DAHEE52/VITA-SmartHome/브레드보드_최종배치_v4.md

# 브레드보드 최종 배치도 (서보모터·INA219 제외)

## 보드 1 — ESP32-S3 (환경 센서 허브)

| 부품 | 위치 | 비고 |
|---|---|---|
| ESP32-S3 | 4~10행, e열(왼쪽 헤더) / i열(오른쪽 헤더) | f·g·h열은 비어있어 점퍼 공간으로 활용 가능 |

### I2C 센서 (BME280 · OLED · BH1750) — 21~25행, a·b·c열
| 행 | 신호 | a열 (BME280) | b열 (OLED) | c열 (BH1750) |
|---|---|---|---|---|
| 21 | 전원 (VIN/VCC) | BME280 VIN | OLED VCC | BH1750 VCC |
| 22 | GND | BME280 GND | OLED GND | BH1750 GND |
| 23 | SCL | BME280 SCL | OLED SCL | BH1750 SCL |
| 24 | SDA | BME280 SDA | OLED SDA | BH1750 SDA |
| 25 | ADDR | — | — | BH1750 ADDR → 22행(GND)에 점퍼로 연결 |

- 21행 → + 레일 (수수케이블)
- 22행 → - 레일 (수수케이블)
- 23행 → ESP32의 SCL용 핀이 꽂힌 행 (수수케이블)
- 24행 → ESP32의 SDA용 핀이 꽂힌 행 (수수케이블)

### PZEM-004T (UART) — 27~30행, a열 — ⚠️ AC 고전압 주의
| 행 | 신호 | 연결 |
|---|---|---|
| 27 | 5V | + 레일 |
| 28 | RX (PZEM) | ESP32 **D3**행 (= 4행) |
| 29 | TX (PZEM) | ESP32 **D2**행 (= 3행) |
| 30 | GND | - 레일 |

> D2(3행)와 D3(4행)이 e열/i열 중 어느 쪽에 있는지에 맞춰, 28·29행에서 반대쪽 열(비어있는 열)로 점퍼를 빼서 연결하세요.
>
> PZEM 본체(AC 입력, CT 클램프)는 브레드보드에 올리지 말고 케이블로 위 4개 행에만 연결하세요.

---

## 보드 2 — XIAO ESP32-S3 (액추에이터 허브)

| 부품 | 위치 | 비고 |
|---|---|---|
| XIAO ESP32-S3 | 1~7행, d열 / h열 | USB-C에 가까운 핀이 1행 (확정) |

### 사용 중인 D번호
| D번호 | 용도 |
|---|---|
| D0 | 사용 자제 (부팅/리셋 관련) |
| D1 | PIR OUT |
| D2 | 채널1 — 조명 LED 직결 (저항 220Ω, 릴레이 모듈 아님) |
| D3 | 릴레이 IN2 |
| D4 | (INA219 SDA — 이번 문서 제외 대상) |
| D5 | (INA219 SCL — 이번 문서 제외 대상) |
| D6 | 릴레이 IN3 |
| D7 | 릴레이 IN4 |

### PIR (HC-SR501) — 17~19행, b열
| 행 | 신호 | 연결 |
|---|---|---|
| 17 | VCC | + 레일 |
| 18 | GND | - 레일 |
| 19 | OUT | XIAO **D1**행 |

> PIR 본체는 브레드보드에 꽂지 않고, 감지 방향으로 따로 배치 후 케이블로 위 3개 행에 연결

### 조명 LED (채널1, 릴레이 모듈 대신 직결) — 23행, a열
| 행 | 신호 | 연결 |
|---|---|---|
| 23 | LED 애노드(+, 긴 다리) | 220Ω 저항 → XIAO **D2**행 |
| 23 | LED 캐소드(-, 짧은 다리) | - 레일 (GND) |

> 릴레이 모듈이 없는 채널 - GPIO(D2)가 HIGH일 때 저항→LED→GND로 전류가 흘러 켜진다
> (active-HIGH). 상세 배선/저항값 근거는 `firmware/DEVICE_CONTROL_GUIDE.md` §1 참고.

### 릴레이 (3채널, 채널2~4) — 24~26행, a열
| 행 | 신호 | 연결 |
|---|---|---|
| 21 | VCC | + 레일 (5V 필요시 별도 5V 레일) |
| 22 | GND | - 레일 |
| 24 | IN2 | XIAO **D3**행 |
| 25 | IN3 | XIAO **D6**행 |
| 26 | IN4 | XIAO **D7**행 |

> 대부분 Active-LOW (GPIO를 LOW로 만들어야 릴레이 ON). 모듈 실제 라벨 확인 필요.

---

## 다음에 채워야 할 것
- [ ] (제외됨) INA219, 서보모터 — 필요할 때 다시 요청
