DAHEE52/VITA-SmartHome/docs/presentation-demo/screenshots/02-main.jpg

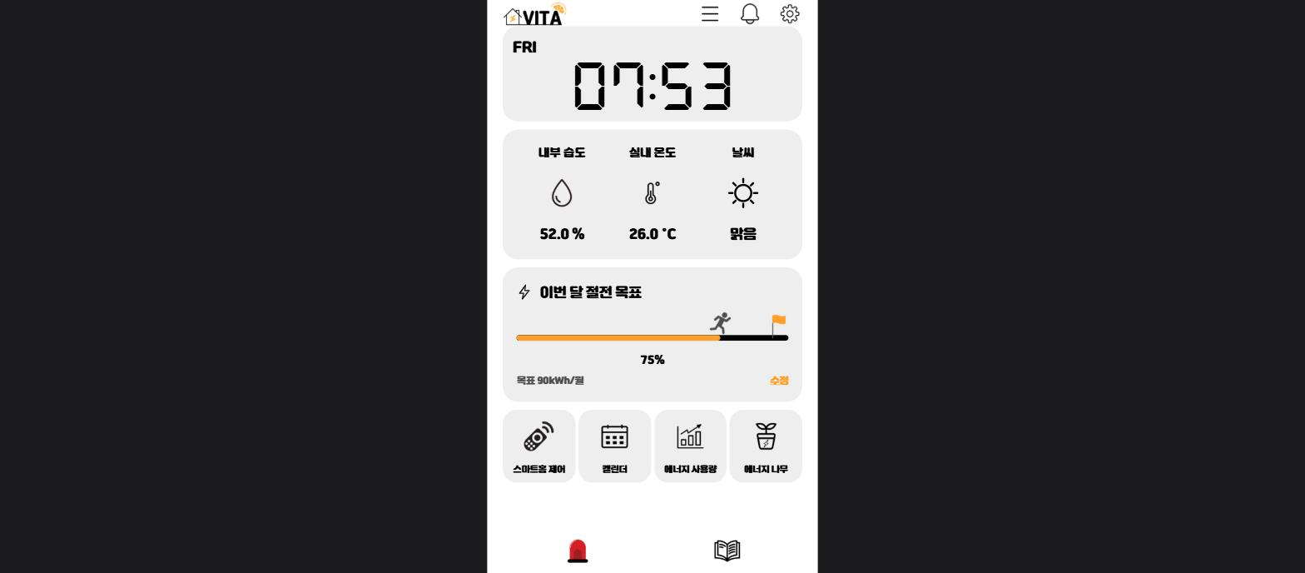
docs/presentation-demo/screenshots/02-main.jpg
