DAHEE52/VITA-SmartHome/guidebook.txt

1. 화재 예방 생활수칙

🔥 화재가 자주 발생하는 원인

- 멀티탭 과부하 및 문어발식 사용
- 사용하지 않는 전기제품 플러그 방치
- 음식 조리 중 자리 비우기
- 휴대폰·보조배터리 과충전
- 담배꽁초 및 라이터 부주의
- 가스레인지 사용 후 밸브 미확인

✔ 생활 속 예방법

- 멀티탭은 정격용량을 확인하고 사용하기
- 전기장판은 접어서 사용하지 않기
- 외출 전 가스와 전기 확인하기
- 충전기는 충전 완료 후 분리하기
- 콘센트 주변 먼지 주기적으로 청소하기

2. 우리 집 화재 위험도 체크

간단한 체크리스트 형식

□ 소화기가 있다.

□ 화재감지기가 설치되어 있다.

□ 비상구 위치를 알고 있다.

□ 멀티탭 과부하 없이 사용한다.

□ 가스레인지 사용 후 밸브를 잠근다.

□ 비상연락처를 저장해 두었다.

점수에 따라

5~6개 : 안전
3~4개 : 주의
0~2개 : 개선 필요

3. 화재 발생 시 행동요령

① "불이야!" 크게 외쳐 주변에 알린다.

② 119에 신고한다.

③ 초기 화재일 경우 소화기를 사용한다.

④ 연기가 많다면

낮은 자세로 이동
입과 코를 가리고 이동
엘리베이터 이용 금지

⑤ 안전한 장소로 대피한다.

⑥ 절대 다시 건물 안으로 들어가지 않는다.

4. 상황별 대처법

🍳 주방 화재
기름에 물 붓지 않기
뚜껑이나 젖은 수건으로 덮기
소화기 사용

🔌 전기 화재
전원 차단
물 사용 금지
전용 소화기 사용

🔥 가스 화재
가스 밸브 잠그기(가능한 경우)
창문을 열어 환기
즉시 대피

🔋 리튬배터리 화재
충전 중 이상 발열 시 즉시 분리
불꽃이 발생하면 가까이 가지 않기
119 신고

5. 자취생을 위한 안전 꿀팁

외출 전 전기제품 플러그 확인하기
멀티탭 하나에 여러 고전력 제품 연결하지 않기
전기장판 위에 이불 겹쳐 놓지 않기
라면 끓이다 잠들지 않기
전자레인지 금속 용기 사용 금지
소화기 위치를 항상 기억하기

6. 아이와 함께 배우는 화재 안전

아이에게 알려주세요
불장난은 절대 하지 않아요.
성냥과 라이터는 만지지 않아요.
불이 나면 숨지 않고 밖으로 나가요.
엘리베이터를 타지 않아요.
119를 누르는 방법을 배워요.

부모를 위한 팁

아이와 함께 대피 연습하기
비상연락처 외우기
화재 발생 시 가족 집결 장소 정하기

7. 우리 집 대피 계획

출입문 확인
비상계단 위치 확인
가족 집결 장소 정하기
반려동물 대피 방법 정하기
야간 대피 경로 확인하기

8. 비상용품 체크리스트

□ 소화기

□ 화재담요

□ 손전등

□ 응급약품

□ 생수

□ 보조배터리

□ 호루라기

□ 비상열쇠

□ 휴대용 라디오

9. 화재 후 해야 할 일

안전이 확인된 후 귀가하기
전기·가스 점검받기
피해 사진 촬영하기
보험사 및 관리사무소 연락하기
가족 건강 상태 확인하기

10. 알아두면 좋은 안전 상식

소화기 사용법 (PASS)

🟢 P(Pull) : 안전핀 뽑기

🟢 A(Aim) : 노즐을 불의 아랫부분으로 향하기

🟢 S(Squeeze) : 손잡이 꽉 누르기

🟢 S(Sweep) : 좌우로 골고루 분사하기

119 신고할 때 말해야 하는 내용

어디에서 불이 났는지
무엇이 타고 있는지
사람이 있는지
자신의 이름과 연락처

11. 긴급 연락처

🚒 119 : 화재 신고

🚑 119 : 응급환자 신고

🚓 112 : 경찰 신고

☎ 가족 비상 연락처

☎ 관리사무소
