DAHEE52/VITA-SmartHome/(commit log)

2026-07-13 init: 메인 대시보드 간격 수정
2026-07-14 feat: 캘린더 날짜 관리, 메인화면 목표 설정, 스마트홈 자동/수동 모드 추가
    - 캘린더: 연/월 선택, 날짜 탭으로 SPECIAL 일정 필터링, 시간 선택 모달(0:00~23:59),
    일정 있는 날짜 표시, DAILY/SPECIAL 항목 추가/수정/삭제 모달 분리
    - 메인화면: 헬스케어 탭을 에너지 나무로 교체, 스트레스 위젯을 기압으로 변경,
    절전 목표에 가구 인원 기반 기본값(평균 소비량 25% 절감) + 자유 수정 기능,
    블록 간격/레이아웃 조정
    - 스마트홈 제어: 기기별 자동/수동 모드 추가(수동일 때만 ON/OFF 직접 토글 가능),
    방 카드 활성 표시를 점 1개로 통일,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
2026-07-15 feat: 알림/설정/가이드북/영수증/화재예방 화면 추가, 에너지/방-기기 상태 전역화 및 실사용 데이터 연동
    - 스마트홈 제어: 방 카드 클릭으로 설정 열기, 방 설정 창 안에서 기기 추가/삭제(확인 단계 포함),
    방/기기 상태를 RoomsContext로 전역화
    - 절전 목표를 GoalContext로 전역화(화면 이동해도 유지), 목표 완전 삭제(초기화) 버튼 추가
    - 알림 시스템 추가: 안읽음 표시, 읽은 알림만 삭제, 첫 접속 웰컴 알림
    - 안전 가이드북 화면 추가: 접이식 섹션, 체크리스트, 가족/경비실 연락처 등록+전화 연결,
    아이 눈높이 이모지 그림, 설정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
2026-07-15 feat: 화재 예방 시스템 AI 감지/자동차단/119 신고, 캘린더 시간 휠 스크롤 수정, 에너지 나무 목표 동기화
    - 화재 예방 시스템: 기기 종류별 정상 지속시간 학습(fireRisk.ts)으로 이상 패턴 실시간 감지,
    감지 시 스마트 플러그 자동 차단 + 알림, 고위험 기기는 119 신고 안내(전화 앱 오픈)까지 연결
    (FireSafetyContext, 화면과 무관하게 항상 감시)
    - RoomsContext에 기기별 점등 시각(onSince)과 자동 차단(forceOffDevice) 추가,
    NotificationsContext에 pushNotification 추가
    - 캘린더 시간 선택 휠: 텍스트가 드래그를 가로채 스크롤이 전혀 안 되던 문제 수정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
2026-07-16 feat: 캘린더/재실 기반 자동화 규칙, 온습도 센서 화재감지, 아이콘 전면 교체 및 에셋 정리
    - 캘린더에 외출/외박 유형 태그·요일별 루틴 추가, 자동화 규칙 화면에서 조명 on/off·목표 온도 자동 제어
    - 재실/외출 감지(카메라 연동 전 시뮬레이션)에 따라 방별 목표 온도 자동 전환
    - 화재 예방 시스템에 온도·습도 더미 센서 연동(연기감지는 제외), 위험 감지 시 자동 차단+119 안내
    - 아이콘/로고 전체를 새 png 세트로 교체(기존 svg 파일 포함), assets/icons·docs 폴더로 프로젝트 정리
2026-07-21 fix: 앱 실행에 필요한 Context Provider 연결 및 의존성 반영
    App.tsx가 이미 존재하는 Context Provider들(Goal/Rooms/Calendar 등)을
    실제로 감싸지 않고 있었고, metro.config.js가 요구하는
    react-native-svg-transformer가 package.json에 누락되어 있어
    다른 환경에서 clone 후 npm install만으로는 정상 실행이 안 되는
    문제를 수정.
2026-07-22 feat: VITA 로고 에셋 교체 및 EAS 빌드 프로젝트 연결
    새 로고 아트로 icons/1-logo.png를 교체하고 중복되던 splash-icon.png는
    제거, 스플래시 화면 태그라인 위치를 로고에 맞춰 조정했다.
    app.json에는 EAS(preview APK) 빌드를 위한 owner/android.package/projectId를 추가했다.
2026-07-22 fix: .env를 git 추적에서 제외하고 .gitignore 비밀값 규칙 복구
    .gitignore가 범용 템플릿으로 교체되면서 .env/backend/.env/firmware
    config.h 제외 규칙이 빠져, .env가 실수로 커밋되어 있었다.
    .env를 git 추적에서 내리고(로컬 파일은 유지) 제외 규칙을 다시 추가했다.
2026-07-22 feat: backend/firmware 코드를 master 브랜치에서 가져옴
    FastAPI 백엔드(backend/)와 ESP32 펌웨어(firmware/)가 origin/master에만
    있고 main에는 빠져있어, 두 브랜치가 서로 무관한 히스토리로 갈라진 상태였다.
    CLAUDE.md가 문서화한 저장소 구조(백엔드/펌웨어 포함)에 맞추기 위해
    해당 디렉토리만 master에서 가져왔다 (다른 파일은 건드리지 않음).
2026-07-22 fix: app.json의 스플래시 이미지 경로가 삭제된 splash-icon.png를 참조하던 버그 수정
    VitaLogo 에셋을 icons/1-logo.png로 교체하면서 splash-icon.png를 지웠는데
    app.json(web splash, expo-splash-screen 플러그인)이 여전히 그 경로를
    참조하고 있어 EAS prebuild가 실패했다.
2026-07-22 fix: Android에서 안전영역이 깨지던 문제 수정 (SafeAreaProvider 누락)
    각 화면이 react-native-safe-area-context의 SafeAreaView를 쓰고 있었지만
    앱 루트에 SafeAreaProvider가 없어서, iOS에서는 우연히 괜찮아 보이고
    Android(특히 edge-to-edge 기본인 최신 버전)에서는 상단바 영역과
    콘텐츠가 겹치는 등 레이아웃 비율이 어긋났다. App.tsx 루트를
    SafeAreaProvider로 감쌌다.
    iOS ad-hoc 빌드를 위해 app.json에 ios.bundleIdentifier도 추가.
2026-07-22 feat: EAS Update 도입으로 Expo Go 영구 공유 링크 지원
    expo-updates 패키지를 추가하고 eas update:configure로 app.json/eas.json을
    설정해, eas update로 게시한 빌드를 다른 사람의 Expo Go에서 별도 dev 서버
    없이 QR/링크로 바로 열어볼 수 있도록 함.
2026-07-22 feat: 메인/에너지사용량 화면을 실제 백엔드(DB)에 연동
    main 브랜치에는 백엔드 연동 코드(src/api/client.ts)가 아예 없어서, 화면의
    모든 상태가 React useState뿐인 목업이었다. 그래서 SmartHomeControlScreen에서
    기기를 켜고 꺼도 저장되는 게 아니라 앱을 재시작하면 초기값으로 리셋됐다
    (사용자 리포트: "변경한 내용이 저장이 안 되어있어").
    - src/api/client.ts 추가 (master 브랜치의 FastAPI 클라이언트를 그대로 사용,
    현재 backend/ 라우터와 호환 확인함)
    - MainScreen: 내부 습도/실내 온도를 /home/summary 실측값으로 표시
    - EnergyUsageScreen: 총 사용량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
2026-07-24 feat: 방/기기 관리 API 추가 및 RoomsContext를 백엔드 연동으로 전환
    - Room CRUD(/rooms), 기기 이름변경/방배정(PATCH /devices/{id}), 프로토타입용
    /devices/mock-register를 새 라우터에 추가하고 devices.room_id 기반으로 스키마 정리
    - RoomsContext가 AsyncStorage 대신 위 API + /devices/{id}/control을 호출하도록 전환
    (모드/onSince/목표온도처럼 백엔드에 없는 값만 로컬에 남김)
    - 각 엔드포인트 정상/에러 케이스 pytest 테스트 추가
2026-07-24 feat: 버튼 press 및 화면 전환 애니메이션 추가
    - TouchableOpacity를 대체하는 AnimatedPressable 추가(누르면 살짝 축소+opacity
    페이드, 떼면 스프링으로 복귀) 후 앱 전체 버튼에 일괄 적용
    - RootNavigator 화면 전환을 fade에서 slide_from_right로 변경
2026-07-24 chore: 사용하지 않는 파일 정리
    - 삭제된 상태로 남아있던 가격검증 엑셀 파일을 git에서도 제거
    - EAS 빌드 산출물(builds/)을 gitignore에 추가
    [2026_경상국립대_AI에너지스마트홈_메이커톤_재료구입리스트_코드코리아_가격검증.xlsx]
2026-07-27 feat: 캘린더/알림/절전목표/설정/자동화 규칙을 백엔드 DB 연동으로 전환
    방/기기 제어 외 나머지 기능들이 앱 재시작 시 초기화되던 문제를 해결한다.
    - 캘린더(schedule_items), 알림함(notifications): 기존 백엔드 API에 프론트를 연결
    - 일정 항목 PATCH 엔드포인트 신규 추가(시간/라벨/종류/날짜/요일 수정)
    - 절전 목표+환경설정용 app_settings 테이블/GET·PATCH /settings 신규 추가
    - 자동화 규칙용 automation_rules 테이블(jsonb)/CRUD /automation-rules 신규 추가
    - 방 이름 변경 후 다른 기기를 추가하거나 목표 온도를 바꾸면 이름이 원래대로
    되돌아가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
2026-07-28 fix: 메인화면 시계 카드 축소 및 하단 여백 균등 분산
    시계 카드와 헤더 상단 여백을 줄이고, 카드 사이 남는 여유 공간이
    하단 네비 위에만 몰리지 않도록 justifyContent:space-evenly로 분산했다.
2026-07-28 feat: 카메라 기반 재실 감지(XIAO ESP32S3 + Edge Impulse) 추가 및 앱 연동
    PIR 센서는 움직임이 없으면(수면, TV 시청 등) 재실을 놓치므로, 프레임 단위로
    occupied/empty를 분류하는 비전 모델을 학습시켜 presence_vision_node로 배포했다.
    백엔드에 presence_cam 기기 타입과 /home/summary presence 필드를 추가하고,
    PresenceContext가 이 값을 폴링해 자동화 규칙의 재실 트리거를 실제 감지 결과로
    동작시키도록 연결했다(AutomationScreen의 수동 시뮬레이션 스위치는 읽기 전용으로 전환).
2026-07-28 feat: 취침 감지/생활 패턴 분석 기능 추가 및 원룸 전용으로 방 관리 단순화
    - 취침 모드: PIR/카메라만으로 재실+조명OFF+무움직임 30분 감지 → 확인 알림 → 자동 활성화되는
    4단계 상태머신(SleepContext)과 관리/통계 화면(SleepModeScreen/SleepStatsScreen) 추가
    - 생활 패턴 분류(LifePatternContext/LifePatternScreen) 및 백엔드 저장 엔드포인트 추가 -
    비전 모델 배포 전까지는 빈 상태를 정직하게 안내
    - 메인화면에 실시간 절감액 카드, AI 추천 배너, 수면중 배너 추가
    - 화재 감지에 5분 내 5도 이상 급상승 판정 추가
    - 스마트홈 제어: 방을 여러 개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
2026-07-29 fix: 메인화면 습도 표시 소수점 첫째자리로 반올림, env_presence_node PIR 센서 선택적 처리
    [env_presence_node.ino]
2026-07-29 feat: 메인화면 습도/온도를 30초 간격으로 자동 갱신
2026-07-29 feat: 원룸 스마트홈 UX 정리 및 백엔드 안정성/DIY 스마트콘센트 연동 개선
    - 낙관적 업데이트 실패 시 롤백 + 알림 공용 헬퍼(rollbackOnFailure) 도입,
    Rooms/Calendar/Automation/Notifications/Settings/Goal/Sleep 8개 Context에 적용
    (저장 실패 시 화면이 조용히 서버와 어긋나던 문제 수정)
    - 백엔드: Supabase 클라이언트 HTTP/1.1 고정 + reload=False로 동시 요청 시
    간헐적 500/프로세스 다운 문제 해결
    - 생활 패턴 분석 기능 제거(화면/Context/라우트/백엔드 pattern 라우터까지 정리)
    - 절전 목표 %와 에너지 나무 성장률 계산을 공용 유틸(goalProgress)로 통일
    - 메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
    [power_relay_node.ino, relay_node.ino]
2026-07-29 feat: BME280+BH1750+OLED+PZEM 통합 환경/전력 허브 노드(env_power_hub_node) 추가
    브레드보드_최종배치_v4.md 보드 1 하드웨어용. 온습도/조도는 living-env-01,
    전력은 living-power-01로 각각 등록해 push하고, OLED는 로컬 표시 전용.
2026-07-29 feat: PIR+4채널 릴레이 액추에이터 허브 노드(actuator_hub_node) 추가
    브레드보드_최종배치_v4.md 보드 2 하드웨어용. PIR은 living-presence-01로
    motion push, 릴레이 4개는 living-relay-01~04로 각각 등록해 명령 poll/적용.
    relay_node(단일 채널) + PIR을 하나의 보드로 통합한 버전.
2026-07-29 feat: 백엔드 AWS Lambda 원격 배포 및 ESP32 펌웨어 HTTPS 전환
    - 백엔드를 AWS Lambda(Function URL)로 배포해 앱/기기가 LAN 없이도 원격 접속 가능하도록 전환
    - 6개 ESP32 노드 전부 WiFiClientSecure로 HTTPS 지원 추가(Lambda가 HTTPS 전용이라 필수)
    - DEPLOY_AWS.md에 2025-10 이후 추가된 lambda:InvokeFunction 권한 요구사항 반영
    - MenuModal에서 BottomNav와 중복되는 홈 메뉴 항목 제거, 체크리스트 최신화
2026-07-29 docs: ESP32 노드 배선/납땜 가이드 추가
    6개 하드웨어 노드(BME280+PIR, 릴레이, PZEM, 카메라)의 핀 연결표와
    AC 전원(릴레이/PZEM) 배선 시 안전 수칙을 정리. README에서 링크 연결.
2026-07-29 docs: 브레드보드 최종 배치도 추가 (env_power_hub_node/actuator_hub_node 배선 참고용)
2026-07-30 perf: 온습도/조도/전력 push 및 앱 폴링 주기를 5초로 단축
    OLED에 뜨는 실시간 값이 앱에도 거의 실시간으로 반영되도록 env_power_hub_node의
    push 주기(30초→5초)와 MainScreen 폴링 주기(30초→5초)를 함께 맞춤.
2026-07-30 refactor: env_power_hub_node에서 OLED 코드 제거
    모든 센서값이 5초 주기로 앱에 push되므로 로컬 OLED 표시가 불필요해짐.
    SSD1306/GFX 라이브러리 의존성과 관련 코드를 전부 제거.
2026-07-30 fix: 취침 확인 알림 재질문 로직 개선 및 릴레이 온라인 판정 버그 수정
    - 취침 확인 알림에서 "나중에"를 누르면 무동작 시간만큼 다시 조용해야 재질문하고,
    "확인"을 누르면 12시간 동안 재질문하지 않도록 변경 (자동 타임아웃 활성화 제거)
    - relay_node가 폴링만 하고 값을 안 보내 last_seen_at이 갱신 안 되던 문제 수정
2026-07-30 feat: Tapo P110M 스마트플러그로 전력 측정 방식 추가 (PZEM 대체)
    AC 배선이 필요한 PZEM 대신, TP-Link Tapo P110M 스마트플러그에서
    python-kasa 대신 tapo 라이브러리로 5초마다 전력(W)을 읽어 living-smartplug-01로
    push하는 backend/tapo_power_bridge.py 추가. 라즈베리파이 systemd 상시 실행 방법과
    Tapo 앱의 "제3자 호환성" 설정(TPAP 암호화 우회)을 SETUP.md에 문서화.
    env_power_hub_node의 PZEM push는 비활성화(코드는 보존).
2026-07-30 feat: Tapo 스마트플러그 자동 검색/원격 제어 추가 및 기기 연결 시 즉시 이름 설정
    - tapo_power_bridge.py: 하드코딩된 플러그 1개 대신 네트워크를 주기적으로 검색해
    Tapo 스마트플러그를 자동 등록하고, 대기 명령을 poll해 on/off를 실제로 실행하도록 확장
    (relay_node.ino와 동일한 명령 큐 패턴 재사용)
    - SmartHomeControlScreen: "스마트 플러그 연결" 목록에서 기기를 고르면 연결과 동시에
    이름 설정 화면으로 이어지도록 개선 - 기존 getUnassignedDevices/renameDevice를 그대로
    재사용해 Tapo/ESP32 기기 모두 동일하게 동작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
2026-07-30 feat: 카메라+PIR 재실 감지 융합, 에너지 사용량 탭 순서 변경
    카메라(occupied/empty AI 모델)가 프레임 단위 분류라 순간 이동/사각지대를
    놓칠 수 있어, PIR이 최근 10분 안에 움직임을 감지했으면 카메라 판정과
    무관하게 재실로 판단하도록 backend home_summary를 개선. 자동화 규칙 화면의
    재실 감지 카드 문구도 카메라 단독 감지가 아님을 반영해 수정.
    에너지 사용량 화면의 연/월/일 탭 순서를 일/월/연으로 변경.
2026-07-30 feat: 조명 채널을 릴레이 대신 LED 직결로 전환, 배선/사용 가이드 문서 추가
    - actuator_hub_node: 채널별 active level 지원(조명=active-HIGH LED 직결,
    나머지=active-LOW 릴레이)로 변경해 두 방식이 한 보드에서 공존 가능
    - DEVICE_CONTROL_GUIDE.md 신규: 조명 ON/OFF 기능의 코드 흐름 + LED 배선(저항값
    계산 포함) + 앱 연결 절차를 처음부터 끝까지 정리
    - 브레드보드_최종배치_v4.md 보드 2 배치를 LED 직결 배선에 맞게 갱신
2026-07-30 feat: 자동화 규칙 실행 시각 직접 지정, 액션을 조명/전력차단/온도로 단순화
    - "몇 분 전에 실행할까요"(오프셋) 대신 "언제 실행할까요"로 구체적인 시각(HH:MM)을
    직접 입력하도록 변경. 트리거 조건이 그날 충족되면 지정한 시각에 정확히 실행된다.
    백엔드 스키마 변경 없이 기존 offset_minutes 정수 컬럼에 "자정 이후 분"으로 인코딩.
    - 원룸 전용이라 "어느 방에 적용할까요" 선택 UI 제거, 항상 유일한 방에 적용.
    - 액션을 조명 켜기/조명 끄기/전력 차단/온도 설정으로 교체(기존의 기기 하나 선택 방식 제거).
    - 온도 설정을 실제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
2026-07-30 perf: 기기/센서 확장에 대비해 기기별 최신 센서값 조회를 DB 뷰 기반으로 전환
    기존에는 metric으로 필터링한 "최근 200행"만 가져와 기기별 첫 값을 취하는 방식이라,
    자주 push하는 센서가 늘어나면 가끔 push하는 센서의 값이 그 200행 밖으로 밀려나
    통째로 누락될 수 있었다(에러 없이 조용히 틀린 값을 반환하는 종류의 버그).
    latest_sensor_readings 뷰(DISTINCT ON device_id, metric)와 지원 인덱스 2개를 추가해서
    DB가 직접 기기/지표별 최신값을 보장하도록 바꿨다 - 기기 수·누적 데이터량과 무관하게
    항상 정확하고, 함수 시그니처/반환 타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
2026-07-30 fix: Settings가 .env의 미정의 키(TAPO_*)에서 크래시하던 문제 수정
    tapo_power_bridge.py가 백엔드와 같은 .env를 공유하는데, pydantic-settings의
    기본 extra=forbid 때문에 TAPO_USERNAME 등을 넣자마자 vita-backend가 부팅 시
    ValidationError로 죽어 재시작 루프에 빠졌다. extra="ignore"로 완화.
2026-07-30 fix: tapo_mqtt_publisher.py를 설치된 tapo==0.9.0 라이브러리 API에 맞게 수정
    - DiscoveryResult는 tapo.discovery_result가 아니라 tapo 최상위에서 바로 export됨
    - discover_devices()는 async iterable을 직접 반환하지 않고 코루틴이라 await 후
    그 결과를 async-iterate해야 함("'async for' requires ... got Coroutine" 에러)
    라즈베리파이에서 실제 Tapo P110M으로 검색/전력측정/MQTT 발행까지 실기기로 검증,
    tapo_mqtt_bridge.py를 통해 배포된 Lambda 백엔드에 기기 등록+실시간 W가 올라오는 것까지 확인.
    requirements.txt의 tapo도 0.9.0으로 고정해 향후 pip install 시 API가 다시 바뀌는 걸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
2026-07-30 refactor: 펌웨어 기기 라벨에서 불필요한 ROOM(거실) 접두어 제거
    VITA는 원룸 전용 서비스라 위치 구분이 필요 없고, 백엔드 DeviceRegister
    스키마에도 room 필드가 없어 실제로는 쓰이지도 않던 값이었다. 8개 노드
    전부에서 ROOM define과 라벨 접두어 코드를 제거하고 기능 이름만 남김.
    이미 등록된 기기들의 라벨은 API로 직접 갱신 완료.
2026-07-30 fix: 주변 기기 감지 목록을 실제 Tapo 스마트 콘센트로만 제한
    /devices/unassigned가 ESP32 센서 노드나 예전 목업/테스트 기기까지 전부 보여줘서,
    앱의 "주변 기기 감지"에 실제로 감지되는 게 아닌 기기들이 섞여 나왔다. 지금 단계에서
    진짜 감지 대상인 스마트 콘센트는 라즈베리파이 Tapo MQTT 브릿지가 등록한 기기(id가
    "tapo-"로 시작)뿐이므로, 그 접두사로 필터링하도록 변경. 테스트 픽스처에 like() 지원
    추가하고 관련 테스트를 mock-register 대신 실제 tapo-* id로 재작성.
2026-07-30 fix: Tapo 전력 누적값 리셋 시 에너지 사용량이 음수로 깎이는 문제 수정
    Tapo 스마트플러그는 PZEM과 달리 리셋 없는 수명 누적 전력량이 없어서,
    tapo_mqtt_publisher.py가 매 폴링마다 순간전력을 구간 적분해 자체
    energy_kwh 누적치를 만들어 bridge를 통해 백엔드로 전달하도록 했다.
    이 값은 프로세스 재시작 시 0부터 다시 쌓이므로, /energy/usage의 버킷별
    차분 계산이 리셋 구간에서 음수가 되지 않도록 값이 감소하면 그 자체를
    사용량으로 취급하게 했다.
2026-07-30 fix: 백엔드 Settings가 .env의 Tapo/MQTT 키 때문에 죽는 문제 수정
    같은 .env를 tapo_mqtt_publisher.py/tapo_mqtt_bridge.py(TAPO_*, MQTT_*,
    API_BASE_URL)와 공유하는 배포(라즈베리파이 한 대에서 백엔드+Tapo 브릿지를
    같이 돌리는 경우)에서, Settings에 선언 안 된 키가 하나만 있어도 pydantic이
    extra_forbidden으로 통째로 기동 실패시켰다. extra="ignore"로 완화.
    실제로 라즈베리파이 재배포 중 vita-backend.service가 이 에러로 죽는 걸
    발견해서 고침.
2026-07-30 feat: 기기별 개별 인증 키(trust-on-first-use)로 전환
    지금까지는 모든 ESP32/Tapo 기기가 DEVICE_API_KEY 하나를 공유했다 - 기기
    하나만 물리적으로 탈취돼도 그 키로 다른 모든 기기를 사칭해 가짜 값을
    주입하거나 릴레이를 조작할 수 있는 구조였다.
    devices 테이블에 device_key 컬럼을 추가하고, 기기가 처음 등록할 때 보낸
    키를 그 기기의 영구 키로 저장한다(trust-on-first-use). 이후 요청은 그
    키와 정확히 일치해야 하고, 다른 기기를 사칭할 수 없다. 이 기능 도입 전
    기존 기기(device_key가 비어있음)는 다음 요청의 키로 자연스럽게
    바인딩되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
2026-07-30 fix: 기기 설정/기기 추가 모달의 버튼 레이아웃 깨짐 수정
    - renameInput에 minWidth:0을 안 주면 웹에서 flex:1 텍스트 입력창이 줄어들지
    않아 옆의 저장 버튼을 카드 밖으로 밀어냈다.
    - modalCloseButtonSolo(flex:0)는 웹에서 flex-basis가 0%로 해석돼 버튼
    높이가 padding만큼(24px)으로 찌그러지고, 그 안의 "닫기" 텍스트가 박스
    아래로 삐져나와 보였다. flexBasis:'auto'로 내용에 맞춰 높이가 잡히게 했다.
2026-07-30 feat: 기기 추가는 Tapo 스마트 콘센트만 인식하도록 제한, 콘센트 연결 상태 표시 추가
    - ESP32 센서/릴레이 노드는 등록돼도 방에 자동 배정하지 않음(tapo- 접두사만 배정) - 원룸이라
    방 배정 자체는 의미 없지만, 스마트 콘센트가 아닌 기기가 기기 목록에 섞이는 걸 방지
    - 스마트홈 제어 화면에서 전력 측정기 카드/설정창에 세 가지 상태를 구분해서 보여줌:
    실제 소비전력(W) / "연결된 기기 없음"(콘센트는 살아있는데 부하가 0W) /
    "콘센트 해제됨"(30초 넘게 신호 없음 - 콘센트 자체 전원이 뽑혔거나 와이파이 끊김)
2026-07-30 feat: 취침 모드를 자동화 규칙 트리거로 추가
    SleepContext가 취침 모드를 실제로 활성화하는(state가 active로 바뀌는)
    순간에 반응하는 새 트리거 kind:'sleep'을 추가. 재실/외출 트리거와 같은
    패턴으로 시각 입력 없이 즉시 발동하며, 기존 조명 켜기/끄기·전력 차단·
    온도 설정 액션을 그대로 재사용한다(스키마/DB 변경 없음, jsonb 컬럼 그대로).
    시각 기반 규칙과 취침 트리거가 액션 실행 로직을 공유하도록
    runRoomAction()으로 추출.
    AutomationContext가 useSleep()을 호출해야 해서 App.tsx의 Provider
    순서를 SleepProvider가 AutomationProvider를 감싸도록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
2026-07-30 feat: 조명(living-light-01) PWM 밝기 조절 기능 추가
    - env_power_hub_node.ino: 조명 채널을 digitalWrite on/off에서 ledcWrite
    PWM(0~100%)으로 전환. D2(스트래핑 핀) 대신 D1 사용.
    - backend: ControlRequest.command가 "on"/"off" 외에 "0"~"100" 밝기 문자열도
    허용하도록 스키마 완화(device_commands.command는 원래 자유 텍스트라
    마이그레이션 불필요). devices.state 낙관적 갱신도 밝기 값 기준으로 on/off 판정.
    - 앱: SmartHomeControlScreen에 조명 전용 밝기 −/+ 스테퍼 추가,
    RoomsContext에 setDeviceBrightness 추가(브라우저 UI로 40/100/10/60%
    전부 실제 LED에서 확인).
    - 라즈베리파이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
2026-07-30 feat: 조명(living-light-01)은 자동/수동 전환 없이 바로 on/off·밝기 조절
    다른 기기는 기존대로 수동 모드에서만 직접 제어되지만, 조명은 자동화
    규칙 대상이 아니라 상시 직접 제어 대상이라 모드 게이팅을 없앴다.
2026-07-30 docs: 기기·센서 수 확장을 전제로 한 설계 원칙 섹션 추가
    메이커톤 프로토타입 단계를 넘어 실제 배포를 가정할 때 지켜야 할 규칙(고정 개수 가정 금지,
    기기 ID 하드코딩 금지, 기기별 인증 키, 멱등 마이그레이션, 배치 폴링)을 CLAUDE.md에 정리했다.
2026-07-30 feat: 자동화 규칙을 캘린더/취침 트리거 + 콘센트 선택 액션 방식으로 재설계
    재실 감지·온도 유지 로직이 삭제된 ESP32 센서에 의존하던 문제를 해결하기 위해, 자동화
    규칙 트리거를 캘린더 기반(외출·외박 일정 통합, 요일별 루틴)과 취침 모드로 한정하고,
    액션은 방 전체 일괄 차단 대신 규칙마다 대상 콘센트를 직접 골라 켜고 끄는 방식으로 바꿨다.
    아직 실제로 연동되지 않은 조명은 고정 id(LIGHT_DEVICE_ID)로 선택만 가능하게 해뒀다.
2026-07-30 fix: 캘린더 화면 스크롤 누락 및 기기 이름 텍스트 오버플로우 수정
    캘린더 화면 본문에 ScrollView가 없어 SPECIAL 일정 일부와 추가 버튼, 하단 네비까지 화면
    밖으로 잘려 접근 불가능했던 문제를 고쳤다. 에너지 사용량/에너지 나무 화면에도 MainScreen과
    동일한 "평소엔 꽉 차게, 필요하면 스크롤"(flexGrow) 안전망을 추가했다.
    화재 예방 시스템의 "AI 이상 패턴 감지"와 취침 모드 관리의 기기 목록은 사용자가 자유롭게
    길게 지을 수 있는 기기 이름을 flex/numberOfLines 없이 상태 배지와 한 줄에 배치하고 있어,
    긴 이름이 카드 밖으로 삐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
2026-07-30 refactor: 취침 모드 관리를 별도 화면 대신 자동화 규칙 화면으로 흡수
    취침 모드 관리(SleepModeScreen)의 취침 감지 조건(시작 시각/무움직임 시간)
    설정과 취침 모드로 전환될 기기 설정 UI를 그대로 자동화 규칙 화면의
    "🛏 취침 모드" 버튼(모달)으로 옮겼다. 데이터/동작(SleepContext.preset,
    /sleep/preset API, 취침 감지 상태머신)은 전혀 안 바뀌었고 UI 진입 경로만
    정리한 것 - 메뉴/설정 화면의 "취침 모드 관리" 진입점은 제거하고 자동화
    규칙 화면으로 안내하도록 갱신.
2026-07-30 docs: room.targetTemp 삭제 반영 안 된 주석 정리
    Room 타입에서 targetTemp가 이미 제거됐는데(온도 유지 자동화 삭제) 이를
    언급하던 SmartHomeControlScreen 상단 주석이 남아있어 정리했다.
2026-07-30 feat: 화재 비상 연락망 연동, 설정 화면에서 기기관리/취침모드 카드 제거
    - EmergencyContactsContext 추가 - 화재 확인 시간 초과 시 등록된 비상
    연락처에 자동으로 알림을 보내고, 화재 경보 모달에서 바로 전화 연결.
    - FireSafetyContext/fireRisk.ts가 이 연락망을 참조하도록 연동.
    - SmartHomeControlScreen: 릴레이 제어보드·환경/재실 센서처럼 사용자가
    직접 켜고 끄는 대상이 아닌 기기는 isControllableSmartDevice(utils/devices.ts)로
    걸러 카드 목록에서 제외.
    - 설정 화면의 "기기 관리"/"취침 모드 설정" 카드는 각각 스마트홈 제어·
    자동화 규칙 화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
2026-07-30 feat: 화재 위험 감지 시 Solapi SMS 비상 알림 발송
    기기 이상 패턴 감지 엔진(app/anomaly/ - Welford 통계 기반 학습 프로필 +
    6개 조건 규칙 채점, "danger" 등급 시 스마트 플러그 자동 차단, 프런트 확인/
    에스컬레이션 UI 포함)이 devices.py의 POST /devices/{id}/readings 경로에
    이미 연결돼 있었다. 이 커밋은 그 위에 "danger" 등급의 마지막 조각이던
    비상 연락처 알림을 실제 SMS 발송으로 완성한다.
    - app/services/sms_service.py: SmsProvider 인터페이스 + SolapiProvider
    구현체(나중에 다른 게이트웨이로 교체 가능). 비상 연락처가 없거나 Solapi
    키가 없으면 조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
2026-07-30 feat: 기기 이상 패턴 감지를 화재 예방 화면에 연동하고 학습 기간 커버리지 개선
    - FirePreventionScreen이 프런트 전용 더미 로직(정상 지속시간 초과 판정) 대신
    백엔드(backend/app/anomaly/)가 계산한 점수/등급/근거를 그대로 보여주도록 교체
    - 학습(14일) 기간이 안 끝났어도 개인 데이터가 필요 없는 조건(장시간 사용·무재실·
    온도 급상승)은 학습 중에도 바로 감시하도록 판정 게이트를 조건별로 분리 -
    헤어드라이기·충전기처럼 가끔 꽂아 써서 표본이 잘 안 쌓이는 기기도 최소한의
    보호를 받도록 함. 표본 의존 조건(전력 이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
2026-07-30 fix: 기기 상태 재동기화 추가, /home/summary 폴링 4곳→1곳 통합, 알림/에너지 조회 무제한 증가 방지
    - RoomsContext가 초기 로드 이후에도 20초마다 /rooms를 다시 조회해 기기 on/off
    상태를 백엔드와 맞춘다. 지금까지는 앱이 보낸 명령을 낙관적으로 믿기만 해서,
    Tapo 앱에서 직접 끄거나 명령이 조용히 실패하면 화면이 실제 상태와 어긋난 채로
    다음 재시작 전까지 남아있었다. 이름/모드/밝기 같은 로컬 전용 값은 유지하고,
    이미 켜져 있던 기기의 onSince(화재 예방 시스템이 참고)는 안 건드린다.
    - HomeSummaryContext를 새로 만들어 /home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
